zemli777/cdx/README.md

# Устроство кодирования и декодирования по коду Хэмминга

Собран проект в Multisim для 16 разрядного кодирования и 21 разрядного декодирования по коду хэмминга. Написан комплект документации включающий: принципиальную и функциональную схемы, набор временных диаграмм работы устройства, спецификацию и расчетно-пояснительную записку.

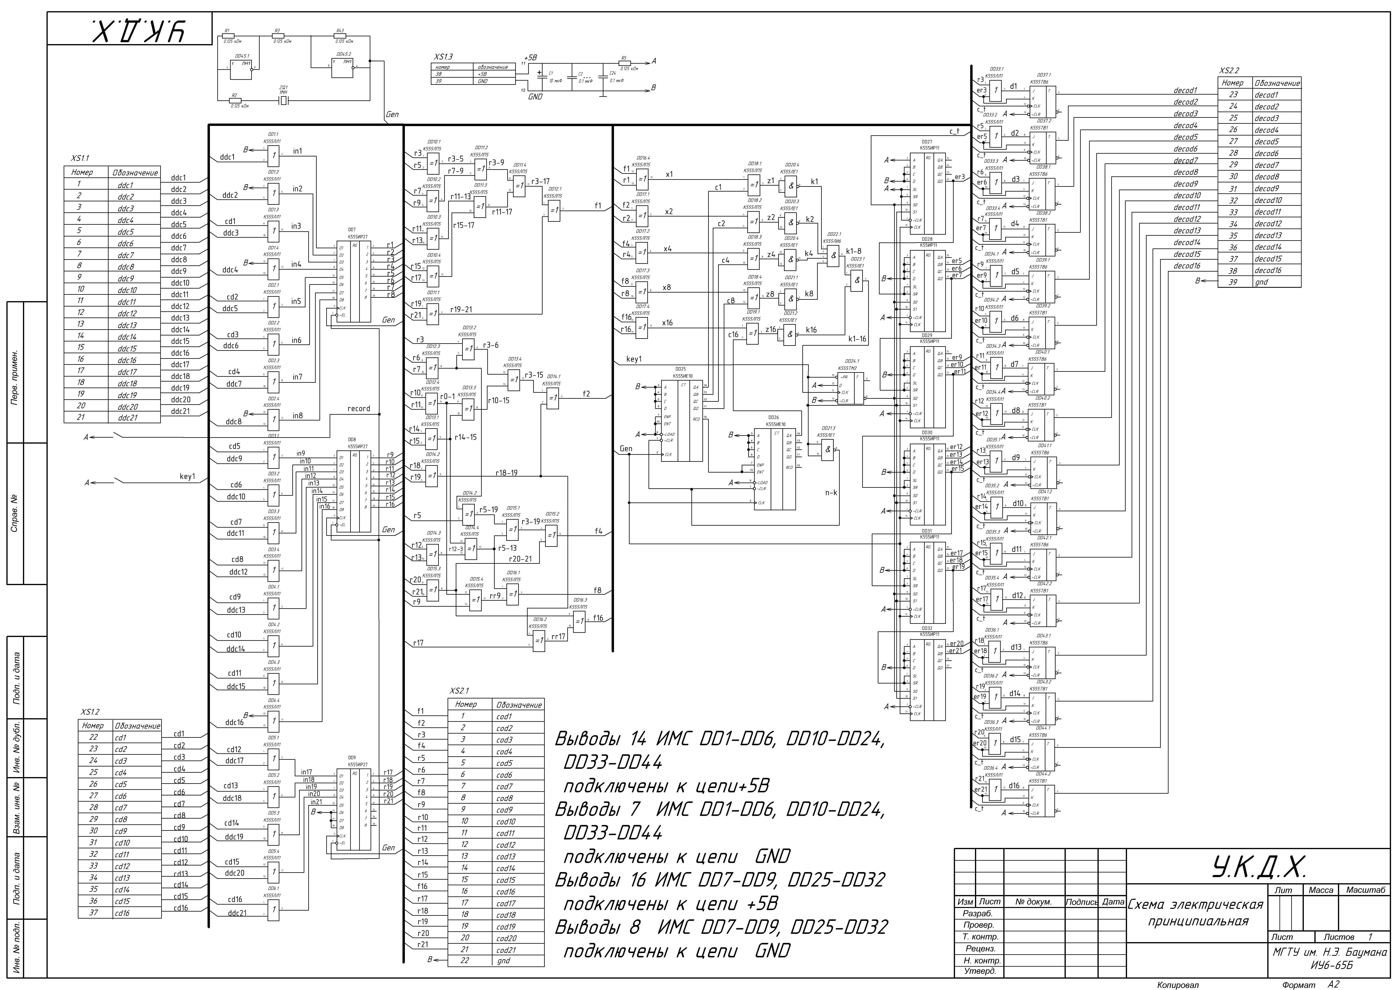
[picture p1: принципиальная_финал.png]
