zemli777/cdx/спецификация.pdf

Подп. и дата Взам. инв. № Инв. № подл Подп. и дата

Утв.

Инв. № дубл.

А3

Микросхемы

Временные диаграммы

Изм. | Зона Лист | Поз. | № докум Подпись Формат DD10-DD19 | К555ЛП5 | 10
| | | DD20-DD21 | К555ЛЕ1 | 2
| | | DD22 | К555ЛИ6 | 1
| | | DD23 | К555ТМ2 | 1
| | | DD7-DD9 | К555ИР27 | 3
| | | DD24-DD25 | К555ИЕ10 | 2
| | | DD1-DD6, DD32-DD35 | К555ЛЛ1 | 6
| | | DD26-DD31 | К555ИР11 | 6
| | | DD26-DD43 | К555ТВ6 | 16

принципиальная

1

Конденсаторы

1

А2 | Схема электрическая

А3

Кол.

### Примечание

Обозначение | Наименование

1

Документация

Схема электрическая

функциональная

С2-C12 | КМ5Б-Н90-0,1мкФ ГОСТ 5-621-70 | 22
С1 | К50-68-25-10мкФ ГОСТ 5-635-70 | 1

У.К.Д.Х.

| | Дата
| Разраб. | | Спецификация. Сборочный чертеж. | Литера | Лист | Листов
Пров. | | | Т | | 1 | 1
МГТУ им. Н.Э. Баумана
каф. ИУ6
Группа ИУ6-65Б
