zemli777/cdx/диаграммы_на_подпись.png

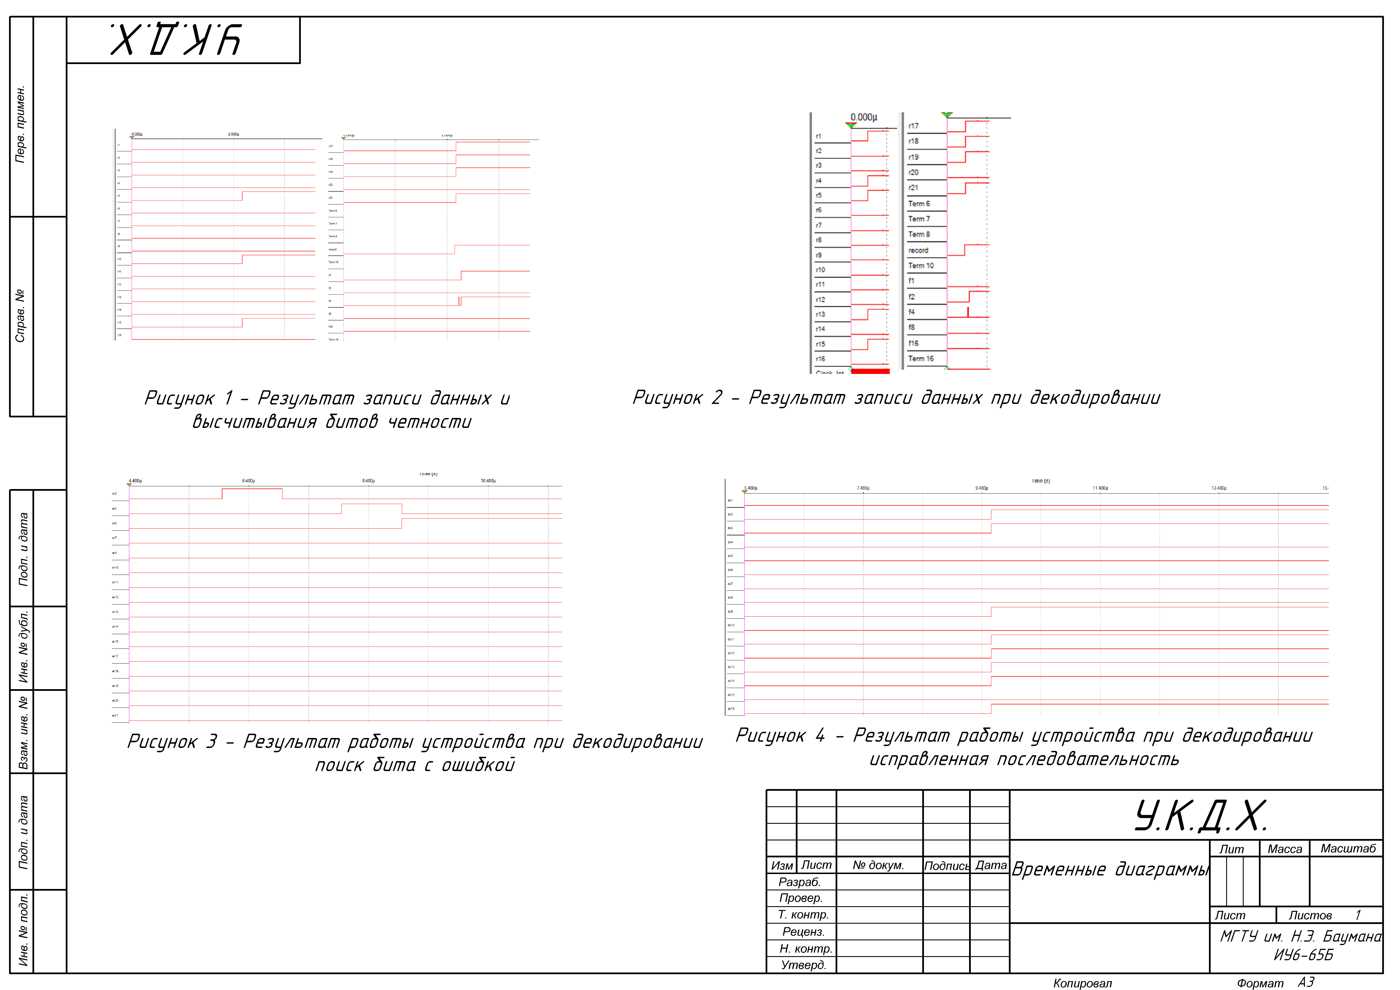
диаграммы_на_подпись.png
