zemli777/cdx/функциональная.png

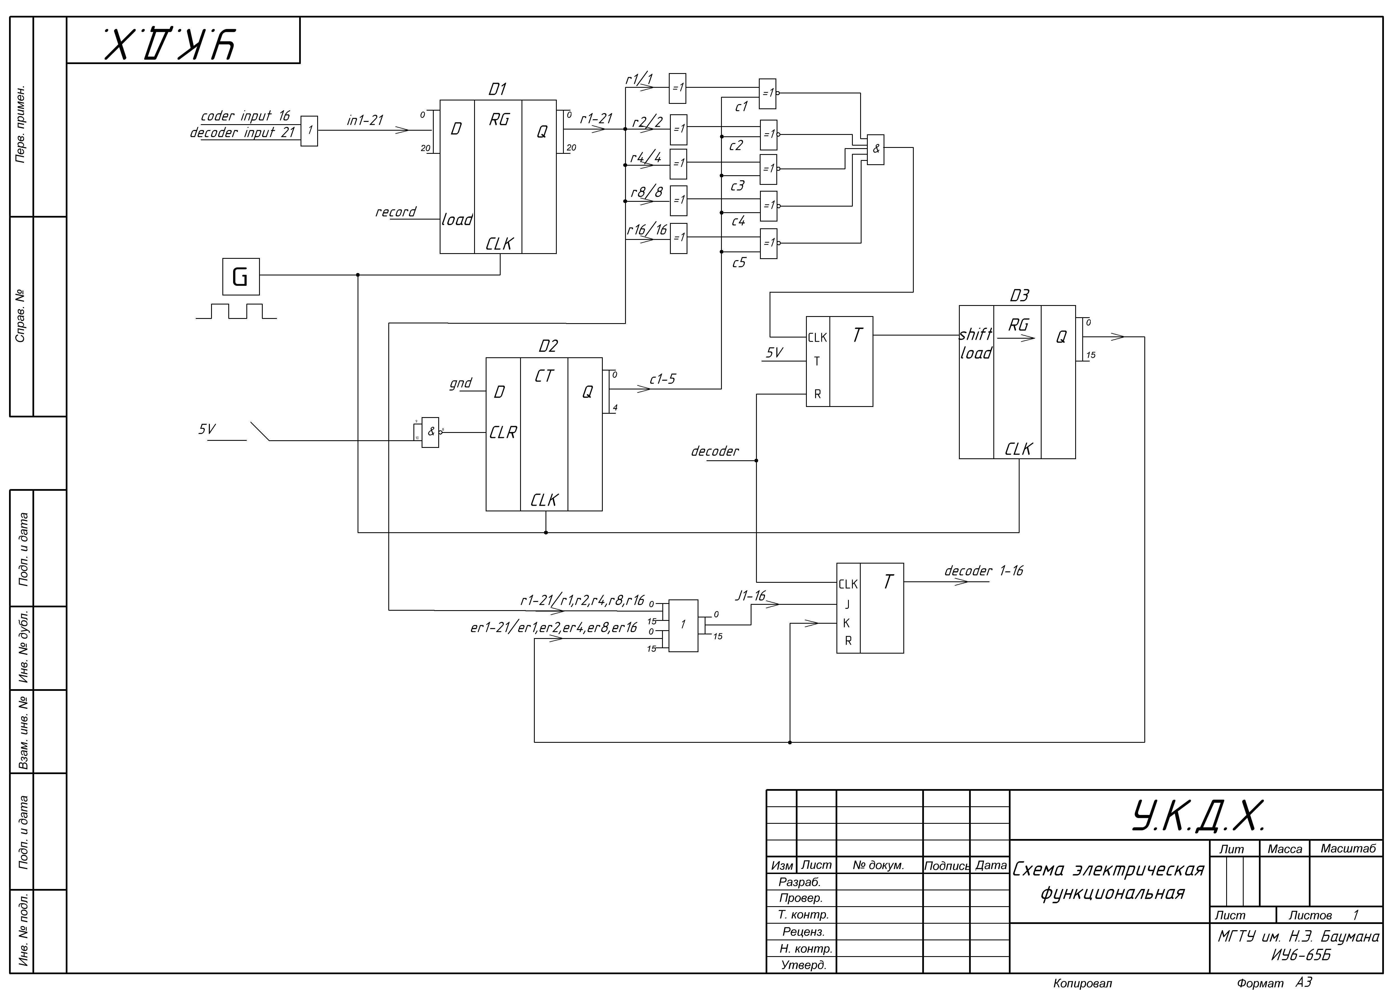
функциональная.png
