zemli777/cdx/(list of files, drawings)

Other design files:
v1_kurs_rayan.ms12
